madhunt/battery_load_tester/(commit log)

2024-02-13 init commit, v1.0 complete
    [battery_load_tester.kicad_pcb, battery_load_tester.kicad_sch]
2024-03-05 v1 updated and printed
    [battery_load_tester-B_Cu.gbr, battery_load_tester-B_Mask.gbr, battery_load_tester-B_Paste.gbr, battery_load_tester-B_Silkscreen.gbr, battery_load_tester-Edge_Cuts.gbr, battery_load_tester-F_Cu.gbr, battery_load_tester-F_Mask.gbr, battery_load_tester-F_Paste.gbr]
2024-03-12 voltage divider in v2
    [battery_load_tester-B_Cu.gbr, battery_load_tester-B_Mask.gbr, battery_load_tester-B_Paste.gbr, battery_load_tester-B_Silkscreen.gbr, battery_load_tester-Edge_Cuts.gbr, battery_load_tester-F_Cu.gbr, battery_load_tester-F_Mask.gbr, battery_load_tester-F_Paste.gbr]
2024-03-29 added switch and updated pcb
    [battery_load_tester.kicad_pcb, battery_load_tester.kicad_sch]
